McMaster-Baja-Racing-Team/GPS-Module/documentation/GPS Implementation Notes.docx

Changing Update Rates

Update rates can be easily changed to 1/5/10 Hz:

Find this line in the code and replace # with 1/5/10:

GPS.sendCommand(PMTK_SET_NMEA_UPDATE_#HZ);

1 Hz is a good value for parsing and printing out data, but it can go faster - use trial and error.

For an update rate that is not 1/5/10Hz:

http://blogs.fsfe.org/t.kandler/2013/11/17/set-gps-update-rate-on-arduino-uno-adafruit-ultimate-gps-logger-shield/

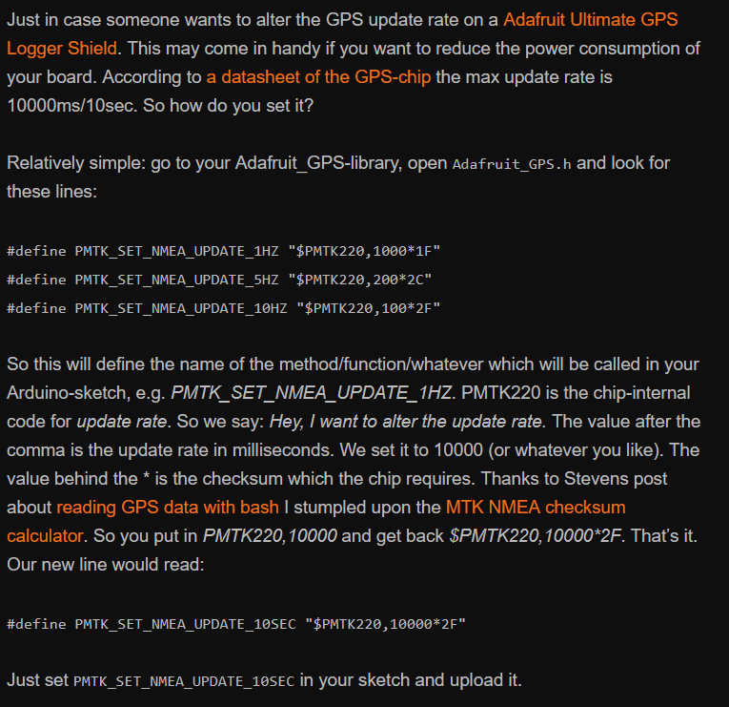
[picture p1: figure]
Machine generated alternative text: Just in case someone wants to alter the GPS update rate on a Adafruit Ultimate GPS Logger Shield. This may come in handy if you want to reduce the power consumption of your board. According to a datasheet of the GPS-chip the max update rate is I 0000msIl Osec. S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

RGB LED Resistors and Changing Colors

With 22/70 Ohm Resistors for all colors:

Orange = RGB(265, 80, 0)

- RGB values will differ from standard web RGB values because we're using the same resistors for all colors even though different colors have different voltage drops.
- If the value of resistors are changed, you'll need update RGB values in the code or you'll get colors you don't want.

Getting other NMEA Data Values

The GPS module currently gets RMC and GGA strings. They provide the following data, (not all are saved to file):

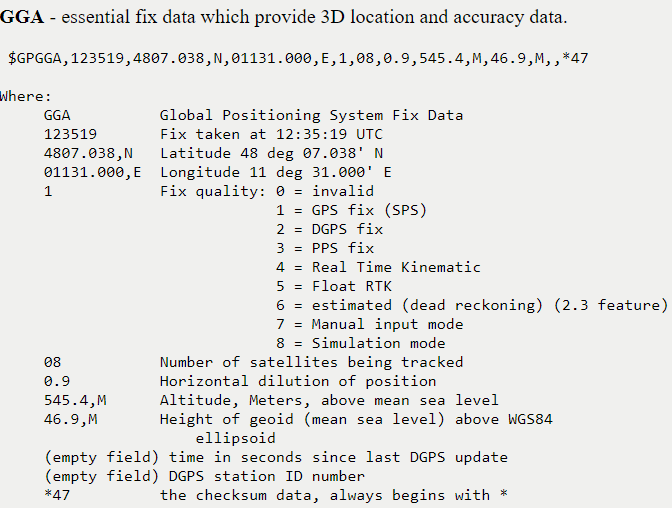
[picture p2: figure]
Machine generated alternative text: GGÅ - essential fix data which provide 3D location and accuracy data. $GPGGA,123519,4807.038,N,01131.000,E,1,08,O.9,543.4,M,46.9,M,,*47 L4here: GGA Global Positioning System Fix Data 123S19 Fix taken at 12:3S:l9 UTC 4807.038,N Latitude 48 deg 07.038’ N 01131.000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
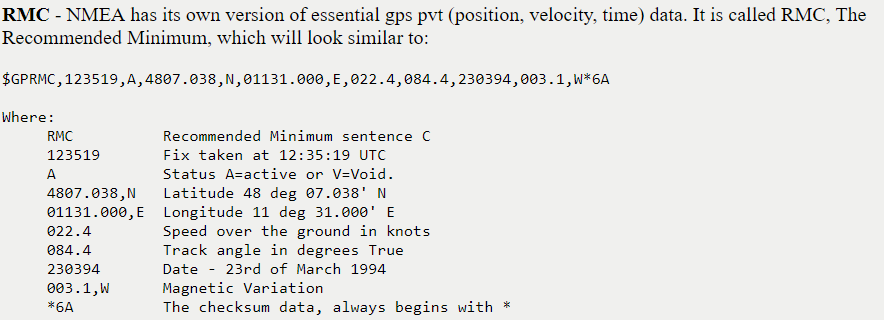
[picture p3: figure]
Machine generated alternative text: R1C - NNIEA has its own version of essential gps pvt (position. velocity, time) data. It is called RMC. The Recommended Mininmm, which will look similar to: $GPRMC,123519,A,4807.038,N,01131.000,E,022.4,084.4,230394,003.1,W*6A Where: RMC Recommended Minimum sente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

- RMC and GGA are the NMEA strings that Adafruit's GPS library is able to parse. You'd have to create your own parser function for other NMEA strings. There are websites which will parse NMEA strings.
- Other strings: http://www.gpsinformation.org/dale/nmea.htm

Code/Layout/Pinouts

on Box

Other Notes

- Try to not share the power pin (3v3) that the GPS module is connected to. The GPS module requires a clean power source and ripples will throw resulting data off.
- Pin out is interchangeable between arduino nano and uno

Implementation NotesAccurate to v.11 of Code
