McMaster-Baja-Racing-Team/GPS-Module/documentation/GPS Breadboard Layout.png

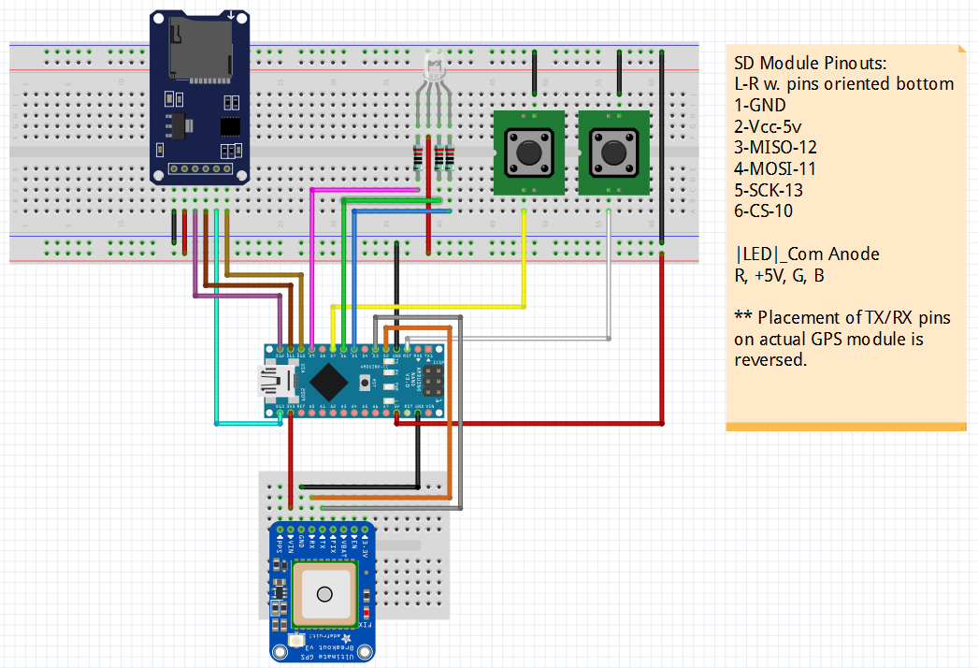
documentation/GPS Breadboard Layout.png
