McMaster-Baja-Racing-Team/GPS-Module/(list of files, drawings)

Other design files:
documentation/GPS_Proto_Nano.fzz
