McMaster-Baja-Racing-Team/GPS-Module/(commit log)

2017-10-24 Added Testing Data Points
    10/22/17 Modified
    [S-10-22-Modified.xlsx]
2017-12-23 Reformat Repo and Add Files
    Changes:
    - Driveday Logs: original and xlsx
    - User guide and documentation
    - File and Folders renamed
    [10-22-Highway-Cleaned.xlsx, 11-25-DD-Cleaned.xlsx, GPS_Proto_Nano.fzz]
